Chihhao/Arduino_Vibration_Logger_SSD1306/README.md

# Arduino_Vibration_Logger_SSD1306 (震動紀錄器)
## 利用 MPU9250 的陀螺儀當作震動偵測器

## 成品如下
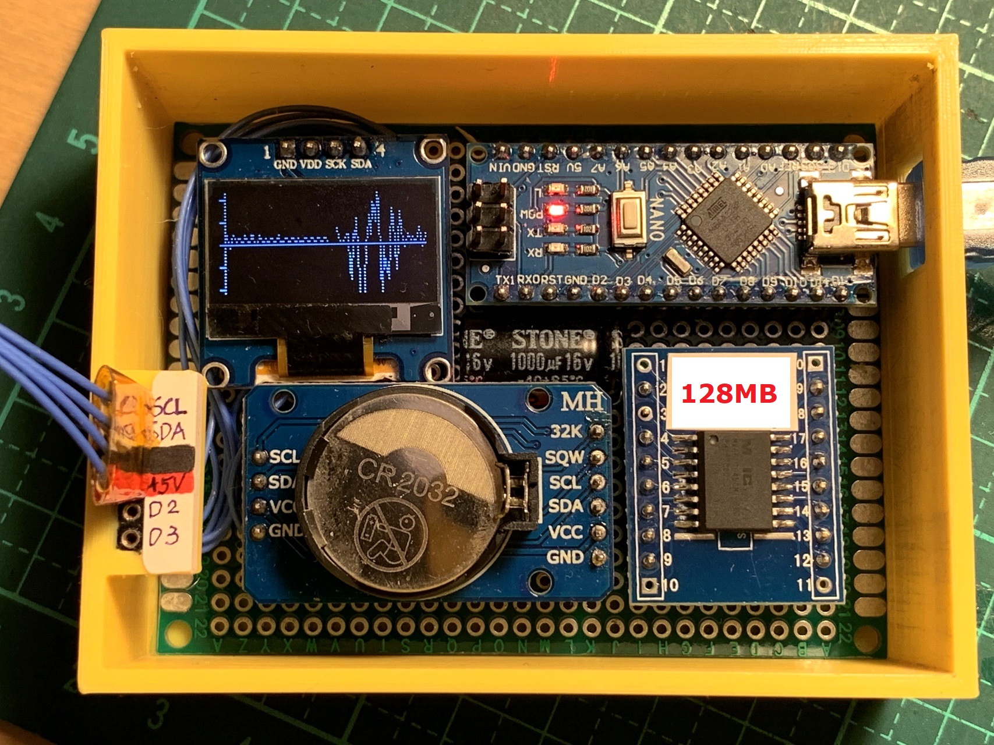
[picture p1: image/IMG_2965.jpg]


## 材料
(1) Arduino Nano  
(2) MPU9250  
(3) 0.96吋OLED (128x64)  
(4) DS3231時鐘  
(5) SPI Nor Flash (Mxic or Winbond)(1Gb)  

## 3D列印外殼
(1) thingiverse: https://www.thingiverse.com/thing:4861300  
(2) tinkercad: https://www.tinkercad.com/things/eZMaNDogAWy  

## 函式庫 
(1) 請複製library目錄中的所有資料到Arduino的library目錄 (ex: C:\Users\USERNAME\Documents\Arduino\libraries)  
(2) 或者可以自行下載，網址如下  
https://github.com/asukiaaa/MPU9250_asukiaaa  
https://github.com/jarzebski/Arduino-DS3231  
https://github.com/adafruit/Adafruit_SSD1306  
https://github.com/Marzogh/SPIMemory  
https://github.com/adafruit/Adafruit-GFX-Library  
https://github.com/adafruit/Adafruit_BusIO  

## 注意
(1) 螢幕解析度實際上只用到128x32，因為使用128x64，Arduino會記憶體不足  
(2) 預設每0.2秒會記錄一筆資料，可以連續紀錄約9天，超過會自動回頭覆蓋，就像行車紀錄器  
(3) Nor Flash 製作成可拆卸式的，需要讀取紀錄的時候，拆下來去另外一個裝置讀取  
(4) 我手上的這顆MPU9250的AD0必須上拉(可能有損壞)，上拉後I2C地址變成0x69  
    (若沒有上拉，I2C地址是0x68)  

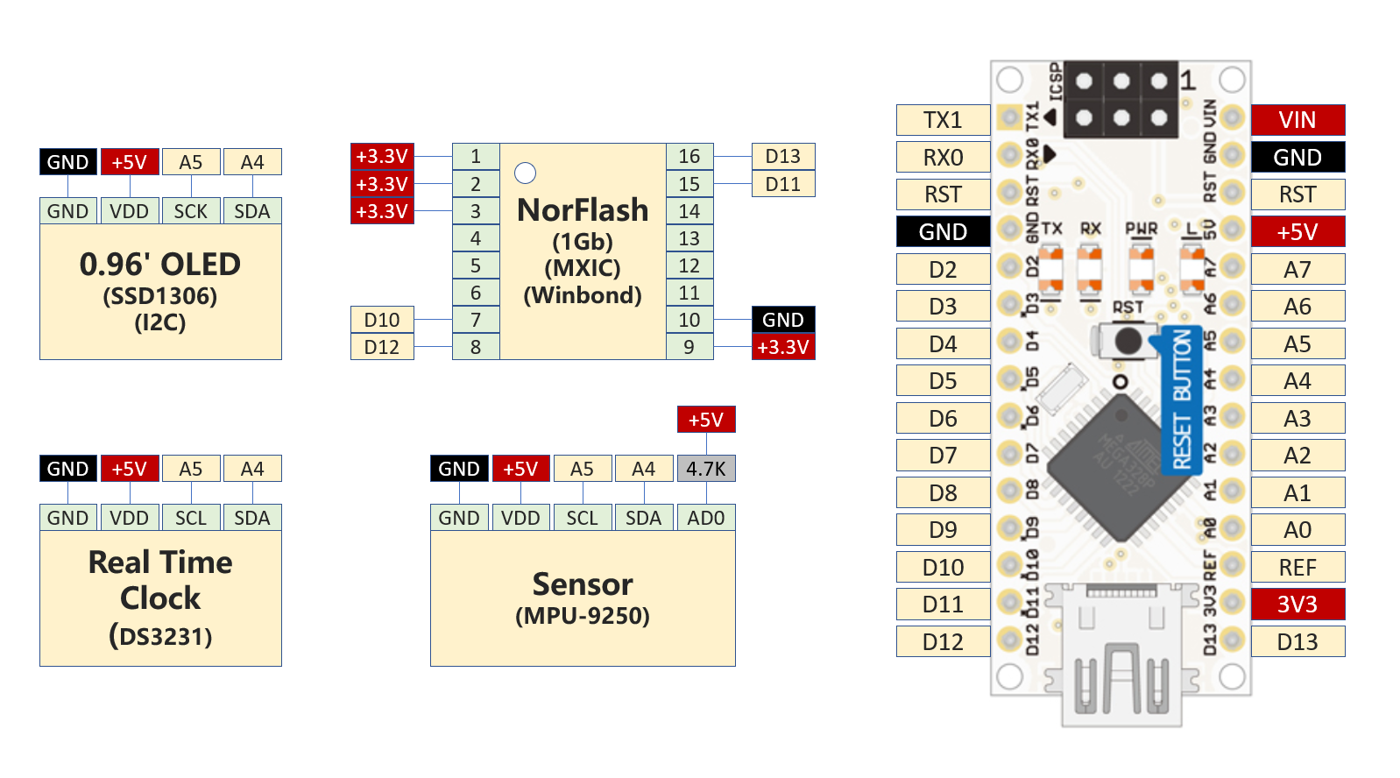
[picture p2: image/wiring.png]

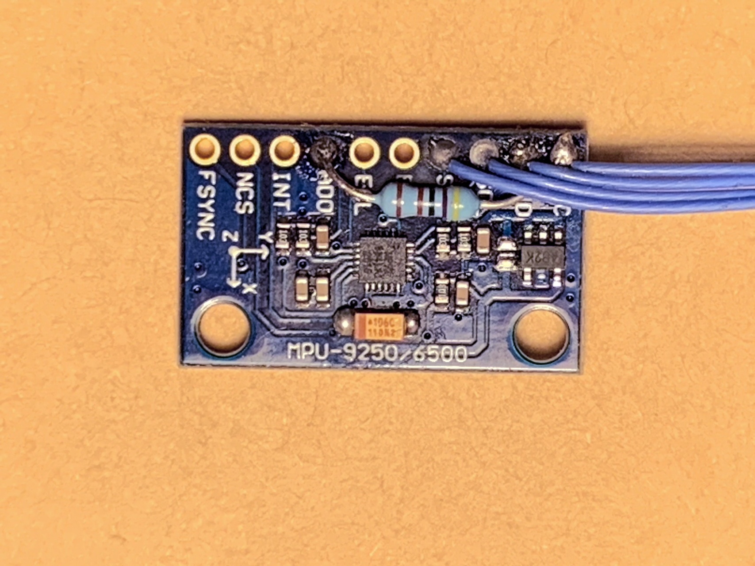
[picture p3: image/IMG_2961.jpg]

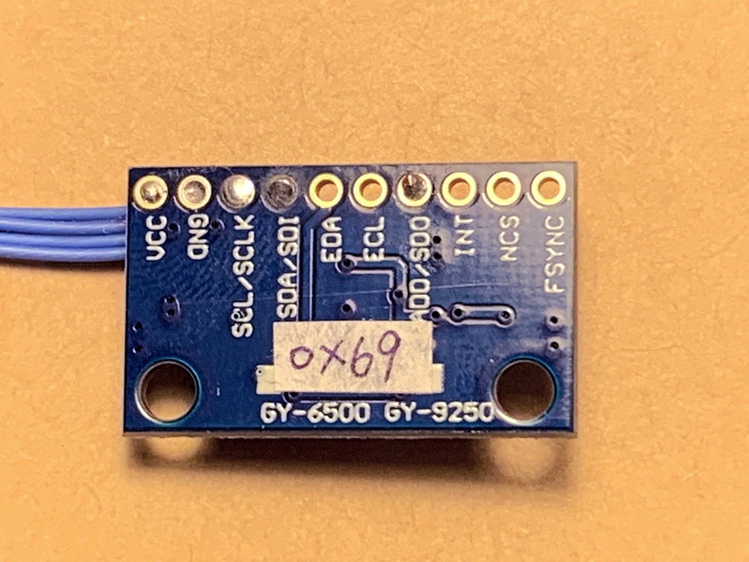
[picture p4: image/IMG_2962.jpg]

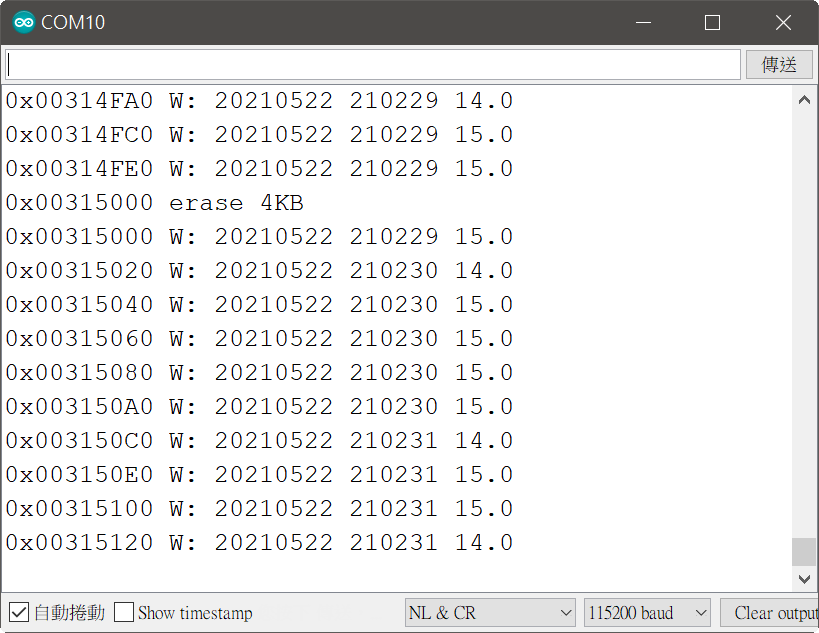
[picture p5: image/log.png]
