Chihhao/Arduino_Vibration_Logger_SSD1306/wiring.pptx

Arduino_Vibration_Logger_SSD1306

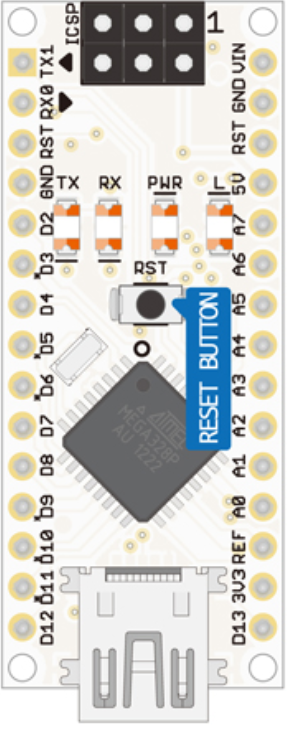
[picture p6: figure]

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
+3.3V

+3.3V

+3.3V

1

2

3

NorFlash
(1Gb)
(MXIC)
(Winbond)

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
+3.3V

+5V

GND

GND

Sensor
(MPU-9250)

+5V

VDD

A5

SCL

A4

SDA

4.7K

AD0

GND

+5V

A5

A4

0.96' OLED
(SSD1306)
(I2C)

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
Real Time Clock
(DS3231)

GND

VDD

SCL

SDA
